sauravshandilya/Air-Quality-Monitoring-CS-671-/README.md

# Air-Quality-Monitoring-CS-671
Code/Documentation for the project done as a part of CS-671 (ICT for Socio-Economic Development)

### Major Goals/Features
* Develop Wireless sensor network with sensor nodes for air quality measurement.  
* A web based visualization tool to interpret sensor data, air quality index.
* A desktop application for configuring and debugging the sensor node.

### References
* [Array of Things](https://arrayofthings.github.io/)
* [Air Quality Monitoring-Central Pollution Control Board, Govt. Of India](http://www.cpcb.nic.in/RealTimeAirQualityData.php)
