sauravshandilya/Air-Quality-Monitoring-CS-671-/Other_documents/stage1_Air_quality_monitoring.pptx

## Air Quality Monitoring

Author: Saurav, Naveen, Parin
Date: 02/03/2017
Version: 1.0

## Problem statement

Goal of the project is to develop Wireless Sensor Node that has the following features :
- On board sensors for measuring various parameter of air quality such as Particulate Matter (2.5), CO emission, Temperature and Humidity
- On board communication
- Low power operation and using solar panel as alternate source of power
- Small form factor
- Sensor stack - provision for add extra sensors in future
- A web based data visualization tool for interpreting sensor data and Air Quality Index
- A desktop tool for debugging the sensor node or to run it in standalone mode

## Solution concept

- Four (04) sensor node with air quality monitoring sensors (CO, PM2.5, temperature and humidity)
- One (01) centralized server
- sensor node senses the surrounding air quality communicates the sensed data to centralized server
- web-server will pick this data from database on centralized server and displays it to the user as real-time graphical plots which include monthly, weekly and daily viewing facility

## Milestones and how far you are?

- Literature Survey and Finalizing Hardware
- Basic Webpage layout, database schema design
- Interfacing CO and Temperature sensor
- Solar Panel Testing
- Sensor Calibration
- Circuit/Stack design
- Standalone Desktop UI
- Wireless communication
- Testing

## Key Challenges

- Finalizing the right hardware
- Design of System architecture
- Designing test cases and resolving issues
- Sensor interfacing and calibration
- Demonstration of project
- Solar power
- Case design
- UI design

Notes: 1.Finalizing the right hardware - sensor, controller, communication module. This is a challenge because we need to explore the low power option, range, sensor reliability, resolution, interfacing, current consumption factor.
2.Design of System architecture and task of each components(Raspberry Pi and microcontroller). We need to think about how different sensor node can communicate amongst themselves/central server specifically deciding the topology (Star, Mesh, Tree), data flow path.
3.Designing test cases and resolving issues. For example, what will happen if particular sensor node stops responding due to some reason, intermittent loss of data packets, interference for external sources.
4.Sensor interfacing and calibration. Interfacing can be easily resolved by reading datasheet. Calibration is challenging. We need find a standard device which can be used for calibration purpose. These standard devices are costly. We have read about system some test setup available with Prof. Virendar Sethi in Energy Science. We will try to explore the option available by further discussion.
5.Demonstration of project - environment with dust and CO will have to be created to demonstrated working of the project.
6.Solar powering of system
7. Case design to keep form factor as small as possible, stackable design

## Final deliverable

- Develop Wireless sensor network with sensor nodes for air quality
measurement
- Stackable sensor node with provision to add more sensors.
- A web based visualization tool to interpret sensor data, air quality index.
- Visualization of sensor node parameters on google map
- A desktop application for configuring and debugging the node

## Hardware Requirements

Sr. No. | Item | Quantity
1 | MSP430 F5529 Launchpad (Microcontroller Board) | 4
2 | CC2530 Zigbee Module | 5
3 | DSM501A Dust Sensor Module | 2
4 | DHT22 - Temperature + Humidity Sensor | 4
5 | MQ7 - CO sensor | 4
6 | Raspberry Pi | 1

## Software Requirements

- Django
- Django - chartit/Matplotlib
- PyQt
- MySQL
- Google Map API
- Code Composer Studio
