sauravshandilya/Air-Quality-Monitoring-CS-671-/Final_Report/images/setup.jpg

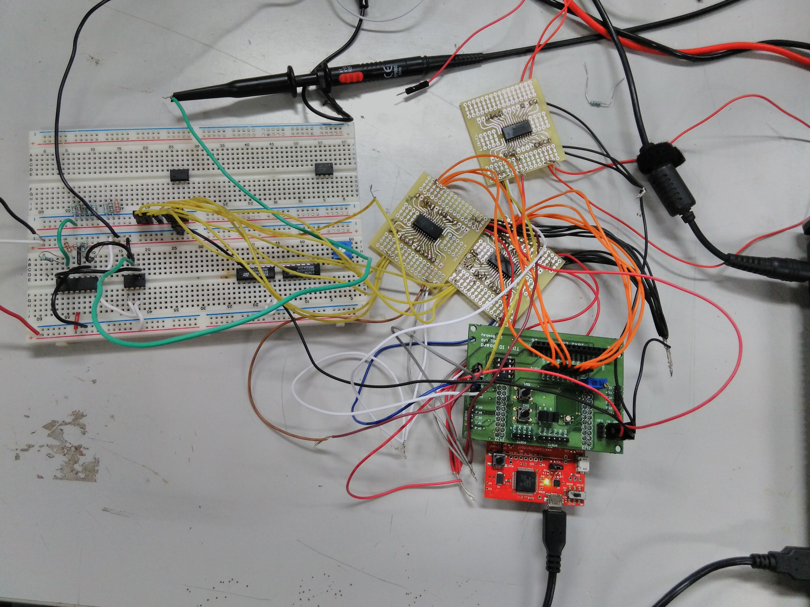
Final_Report/images/setup.jpg
