sauravshandilya/Air-Quality-Monitoring-CS-671-/MSP430_code/test_codes/commonheader.h

/*
 * commonheader.h
 *
 *  Created on: 30-Mar-2017
 *      Author: saurav
 */

#ifndef COMMONHEADER_H_
#define COMMONHEADER_H_

#include <msp430.h>
//#include <driverlib.h>

#endif /* COMMONHEADER_H_ */
