sauravshandilya/Air-Quality-Monitoring-CS-671-/MSP430_code/test_codes/my_delay.h

/*
 * my_delay.h
 *
 *  Created on: 30-Mar-2017
 *      Author: saurav
 */

#ifndef MY_DELAY_H_
#define MY_DELAY_H_

void delay_sec(unsigned int number_of_seconds);
void delay_millisec(unsigned int number_of_milliseconds);


#endif /* MY_DELAY_H_ */
