sauravshandilya/Air-Quality-Monitoring-CS-671-/(commit log)

2017-03-18 Add files via upload
    logged CO value inside erts lab. Calibrated MQ-7 sensor.
2017-03-30 added header files, test code for delay and uart
2017-03-30 modified delay and checked code for uart with delay
2017-04-02 CO sensor working modular code
